GraphTechKEN/MC53_ME38_BVE_VM/SerialOutput割当表.pdf

SerialOutput 割当表
文字順 | 出力情報 | 出力形式(ASCII) | パネル動作(JR) | パネル動作(小田急) | 備考
0 | 速度 | | - | -
1 | | | - | - | 少数第1位から 10進_4桁_乗数1
2 | | | - | -
3 | | | - | -
4 | / | 固定文字 | - | - | -
5 | ドア状態 | 閉:0 開:1 | - | - | -
6 | / | 固定文字 | - | - | -
7 | 電流 | 符号_10進_5桁_乗数1 | - | - | 少数第1位から
8 | | | - | -
9 | | | - | -
10 | | | - | -
11 | | | - | -
12
13 | / | 固定文字 | - | - | -
14 | ﾊﾟﾈﾙ_000 | 10進_1桁_乗数0 | ATS-S白色灯 | 減光 | -
15 | ﾊﾟﾈﾙ_001 | 10進_1桁_乗数0 | ATS-S警報灯 | 定速 | -
16 | ﾊﾟﾈﾙ_010 | 10進_1桁_乗数0 | EB警報表示灯 | 制動 | -
17 | ﾊﾟﾈﾙ_035 | 10進_1桁_乗数0 | 直通ブレーキ表示灯 | 列番10の位 | -
18 | ﾊﾟﾈﾙ_210 | 10進_1桁_乗数0 | 電気ブレーキ表示灯 | ATC-50 | -
19 | ﾊﾟﾈﾙ_211 | 10進_1桁_乗数0 | 抑速ブレーキ表示灯 | ATC-55 | -
20 | / | 固定文字 | - | - | -
21 | ブレーキシリンダ圧力 | 10進_4桁_乗数1 | - | - | 少数第1位から
22 | | | - | -
23 | | | - | -
24 | | | - | -
25 | / | 固定文字 | - | - | -
26 | ﾊﾟﾈﾙ_012 | 10進_1桁_乗数0 | ATS-Ps | 動作 | -
27 | ﾊﾟﾈﾙ_082 | 10進_1桁_乗数0 | ATC-55 | 停車_点滅 | -
28 | ﾊﾟﾈﾙ_043 | 10進_1桁_乗数0 | ユニット3表示灯 | パターン接近 | -
29 | ﾊﾟﾈﾙ_003 | 10進_1桁_乗数0 | (ATS-P)パターン接近 | 勾配起動 | -
30 | ﾊﾟﾈﾙ_004 | 10進_1桁_乗数0 | (ATS-P)ブレーキ解放 | 古ステップ | -
31 | ﾊﾟﾈﾙ_005 | 10進_1桁_乗数0 | (ATS-P)ブレーキ動作 | EB | -
32 | ﾊﾟﾈﾙ_006 | 10進_1桁_乗数0 | ATS-P | 戸閉 | -
33 | ﾊﾟﾈﾙ_007 | 10進_1桁_乗数0 | (ATS-P)故障 | 計器灯 | -
34 | ﾊﾟﾈﾙ_008 | 10進_1桁_乗数0 | - | 抑速 | -
35 | ﾊﾟﾈﾙ_009 | 10進_1桁_乗数0 | - | 力行 | -
36 | ﾊﾟﾈﾙ_031 | 10進_1桁_乗数0 | 非常ブレーキ | VVVF（カラー）0:消灯 1:力行 2:制動 | -
37 | ﾊﾟﾈﾙ_011 | 10進_1桁_乗数0 | Ps電源 | 速度注意 | -
38 | ﾊﾟﾈﾙ_059 | 10進_1桁_乗数0 | - | 回生開放 | -
39 | ﾊﾟﾈﾙ_040 | 10進_1桁_乗数0 | - | OM-ATS電源 | -
40 | ﾊﾟﾈﾙ_041 | 10進_1桁_乗数0 | ユニット1表示灯 | D-ATS-P電源 | -
41 | ﾊﾟﾈﾙ_042 | 10進_1桁_乗数0 | ユニット2表示灯 | 無信号 | -
42 | ﾊﾟﾈﾙ_002 | 10進_1桁_乗数0 | (ATS-P)電源 | 指令S レバーサが中立位置以外で点灯 | -
43 | / | 固定文字 | - | - | -
44 | レバーサ | 前:F 中:N 後:B | - | - | -
45 | 力行ノッチ | 力行"P" 抑速"H" | - | - | -
46 | | 10進_1桁_乗数0 | - | - | 最大9(0～9)
47 | B | 固定文字 | - | - | -
48 | ブレーキノッチ | 16進_2桁_乗数0 | - | - | 最大255(00～FF)
49
50 | M | 固定文字 | - | - | "M"R
51 | 元空気ダメ圧力 (MR) | 10進_3桁_乗数0 | - | - | 空気制御に使用する空気の圧力 (コンプレッサーの圧力) 編成に引通されている圧力
52
53
54 | C | 固定文字 | - | - | B"C"
55 | ブレーキシリンダ圧力 (BC) | 10進_3桁_乗数0 | - | - | ブレーキシューを車輪に押し当てる シリンダの圧力 先頭車に搭載されたブレーキシリンダ圧力
56
57
58 | E | 固定文字 | - | - | "E"R
59 | ツリアイ空気ダメ圧力 (ER) | 10進_3桁_乗数0 | - | - | 自動帯使用時に加減圧を編成両数に 関係なく安定させるためのタンク 先頭車に搭載された制御空気ダメ圧力
60
61
62 | S | 固定文字 | - | - | "S"AP
63 | 直通管圧力 (SAP) | 10進_3桁_乗数0 | - | - | 直通帯使用時、ブレーキ弁角度に ほぼ比例して高くなる 編成に引通されている(直通している)圧力
64
65
66 | P | 固定文字 | - | - | B"P"
67 | ブレーキ管圧力 (BP) | 10進_3桁_乗数0 | - | - | 自動帯(および非常ブレーキ)使用時490kPaか らの減圧量でブレーキシリンダ圧力が高まる 編成に引通されている空気管圧力
68
69
70 | CR(\r) | デリミタ(終端文字列) | デリミタ
