GraphTechKEN/MC53_ME38_BVE_VM/ME38_MC53_BVE_VM_V4.2.0.6_Normal.png

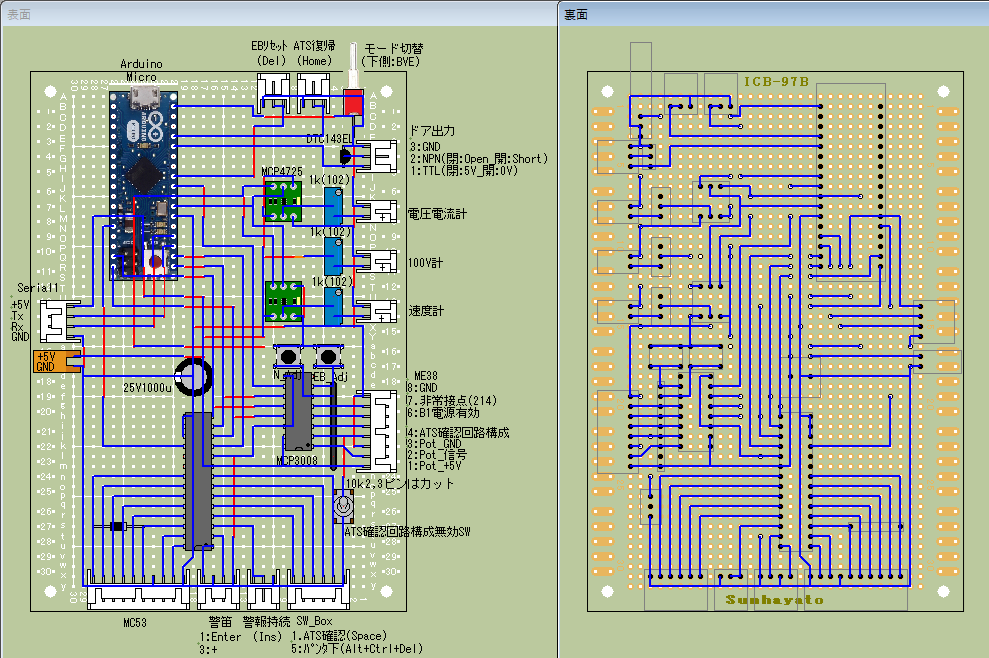
ME38_MC53_BVE_VM_V4.2.0.6_Normal.png
