GraphTechKEN/MC53_ME38_BVE_VM/MC53配線例.pdf

# MC53マスコン配線例

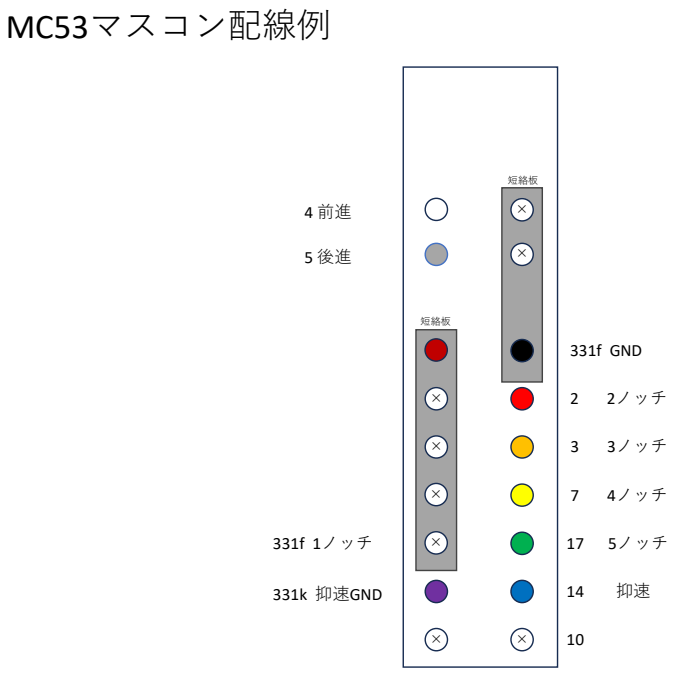
[picture p4: page 1]
17 5ノッチ; 7 4ノッチ; 3 3ノッチ; 2 2ノッチ; 331f 1ノッチ; 331f GND; 331k 抑速GND; 短絡板
