GraphTechKEN/MC53_ME38_BVE_VM/(commit log)

2024-06-17 Add files via upload
    Bug Fix
    [MC53_ME38_BVE_VM.ino]
2024-11-12 V4.1.2.1
    V4.1.2.1 警報持続スイッチ反転を他スイッチに拡張(ATS確認を除く)、抑速-非常接点切替対応、ME38自動帯非常抜取対応
2024-11-13 V4.1.2.2
    V4.1.2.2 実際のエアー圧使用時にもME38非常抜取対応
2024-11-14 V4.1.2.3
    非常ラッチ(EB_latch)解除位置が常用最大手前だったものを修正
2024-11-16 V4.1.2.4
    MC53_ME38_BVE_VM_V4.1.2.4 EBスイッチとATS復帰が反転していたので修正
2024-11-16 V4.1.2.5
    POT_NとPOT_EBの上限修正
2024-11-24 V4.2.0.1
    下位に自動帯情報を伝達、抑速ノッチを廃止(マスコンノッチに統合)
2024-11-24 V4.2.0.2
    ツリアイ管(ER)を追加
2024-11-24 V4.2.0.3
    圧力計の針の動きをソフトにする
2024-12-26 V4.2.0.5
    針の動きを滑らかにした
    自動帯で直通ランプを消灯する
2024-12-27 V4.2.0.6
    N位置で自動ブレーキ作動時は直通ランプを消灯、直通帯で自動ブレーキ作動時は直通ランプを点灯させる
2025-02-02 V4.2.1.1
    V4.2.0.6 N位置で自動ブレーキ作動時は直通ランプを消灯、直通帯で自動ブレーキ作動時は直通ランプを点灯させる
    V4.2.0.7 調整モード(模型運転モード)でノッチオフをP0、緩解をB0、自動ブレーキ時のレバーサ切替を無効とする
    V4.2.1.1 BveEXでの自動帯操作に対応、BveEX起動時、自動帯をB0とし、下位からのBC圧を伝達する
2025-02-13 V4.2.1.2
    BveEX使用時、B0位置で直通ランプが点灯しない不具合修正
2025-02-14 V4.2.1.3
    直通帯でBCが動かない不具合を修正(！要SerialOutputEx更新)
2025-03-08 V4.2.1.4
    JRETS185系に仮対応
